mucahitc/Anten-Takip-PCB/README.md

# Anten Takip Sistemi — STM32H523 Kontrol Kartı

**Hareketli bir modülün konumunu kullanarak yönlü anteni iki eksende yönlendiren sistemin elektronik kontrol kartı.**

Bu depo; anten takip projesinin sabit modülüne ait **Altium Designer şematiklerini, dört katmanlı PCB tasarımını, bileşen kütüphanelerini, şematik PDF çıktısını ve STM32 yazılım başlangıç projesini** içerir.

<p align="center">
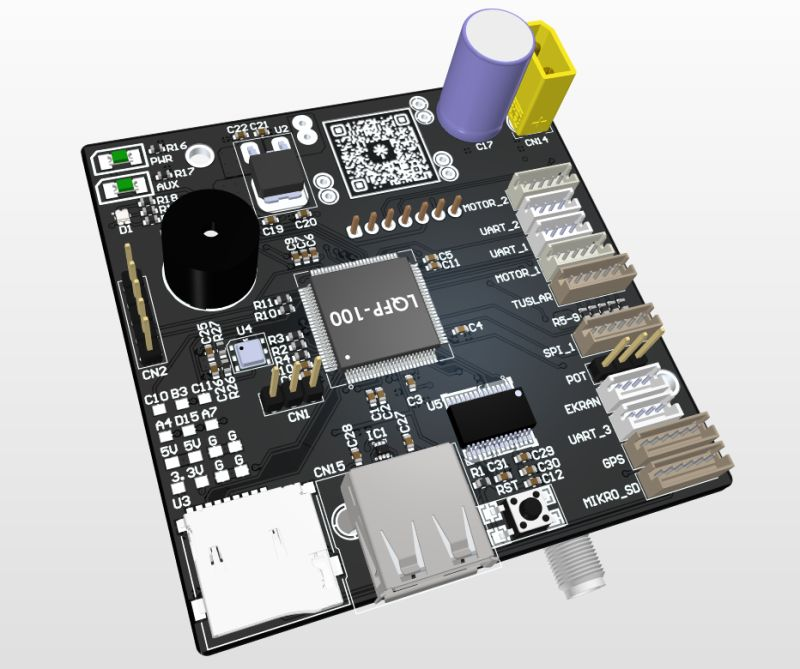
[picture p1: 1778805402399.jpg]
Anten takip kontrol kartının üç boyutlu tasarım görünümü
  
</p>

<p align="center"><em>STM32H523 tabanlı kontrol kartının üç boyutlu tasarım görünümü.</em></p>

[Şematik PDF](Job1.PDF) · [Altium projesi](Anten_Tracker_Karti.PrjPcb) · [PCB tasarımı](Anten-Tracker-PCB.PcbDoc) · [STM32 projesi](Anten_Tracker.zip)

## Proje hakkında

Anten takip sistemi, takip edilecek platforma yerleştirilen hareketli modül ile yerde bulunan sabit modül arasında konum verisi aktarılmasına dayanır. Sabit modül, kendi konumu ile hareketli modülün konumunu birlikte değerlendirerek antenin bakması gereken azimut ve elevasyon açılarını hesaplayan sistemin kontrol merkezidir.

Hareketli modül; İHA, İDA veya başka bir hareketli platforma yerleştirilebilecek şekilde düşünülmüştür. Takip edilen unsur bu modüldür; farklı araçlara uyarlama, ilgili platformun montaj ve kullanım koşullarına göre yapılır.

Bu depodaki PCB, projenin **sabit modül kontrol kartıdır**. Mekanik tasarım ve yer kontrol arayüzü sistemin diğer parçalarıdır; bu depo ağırlıklı olarak elektronik tasarıma odaklanır.

## Sistem nasıl çalışıyor?

mermaid-diagram

1. Hareketli modül, konum ve yükseklik verilerini toplar ve LoRa üzerinden gönderir.
2. Sabit modül, gelen verileri yerel konum ve yükseklik bilgileriyle birlikte değerlendirir.
3. Hesaplanan yön bilgisine göre yatay ve düşey eksenler kontrol edilir.
4. Yatay eksenin konumu potansiyometre üzerinden geri beslenir; telemetri ve sistem bilgileri yer kontrol istasyonuna aktarılır.

Bu akış, bütün sistemin çalışma prensibini gösterir.

## Donanım özellikleri

| Birim | Bileşen / yapı | Görevi |
| --- | --- | --- |
| Mikrodenetleyici | **STM32H523VET6**, LQFP100 | Çevre birimlerini ve kontrol bağlantılarını yönetme |
| PCB | **4 bakır katman** | Sinyal yönlendirmesi, güç dağıtımı ve toprak yapısı |
| Kablosuz haberleşme | **LoRa E22**, CARD1 | Hareketli modülle telemetri bağlantısı |
| USB–UART | **FT232**, U5 | Yer kontrol istasyonuyla seri haberleşme |
| USB hat elemanı | **NUF2042XV6T1G**, IC1 | USB hatlarında filtreleme ve ESD koruma işlevi |
| 5 V besleme | **MP1584EN modülü**, CARD2 | Şematikteki 12 V giriş hattından 5 V üretme |
| 3,3 V besleme | **LD1086DT33TR**, U2 | 5 V hattından 3,3 V üretme |
| Basınç sensörü | Şematikte **BMP180** olarak tanımlanan U4 | Barometrik ölçüm için I²C bağlantısı |
| GNSS SE100 bağlantısı | UART + I²C, CN8 | Harici konumlandırma modülüne bağlantı |
| Konum geri beslemesi | Analog potansiyometre girişi, CN7 | Yatay eksenin konumunu okuma |
| Motor arayüzleri | Zamanlayıcı çıkışları, CN3 ve CN4 | Harici sürücülere kontrol sinyallerini taşıma |
| Depolama bağlantısı | microSD yuvası U3 ve harici bağlantı CN6 | SPI tabanlı depolama altyapısı |
| Yerel kullanıcı arayüzü | Ekran ve beş yönlü tuş bağlantıları | Durum gösterimi ve kullanıcı girişi |
| Göstergeler | 0.96" OLED, RGB LED, durum LED’leri ve buzzer | Görsel ve sesli bildirim altyapısı |
| Geliştirme erişimi | SWD, BOOT0 ve reset | Programlama ve hata ayıklama |

Motor soketleri kontrol bağlantılarını dışarı taşır; DC motorun güç sürücüsü harici birimdir. microSD ve ek arayüzlerin kart üzerinde bulunması, tüm işlevlerin paylaşılan yazılımda uygulanmış olduğu anlamına gelmez.

## PCB yerleşimi

<table>
  <tr>
    <th>Ön yüz</th>
    <th>Arka yüz</th>
  </tr>
  <tr>
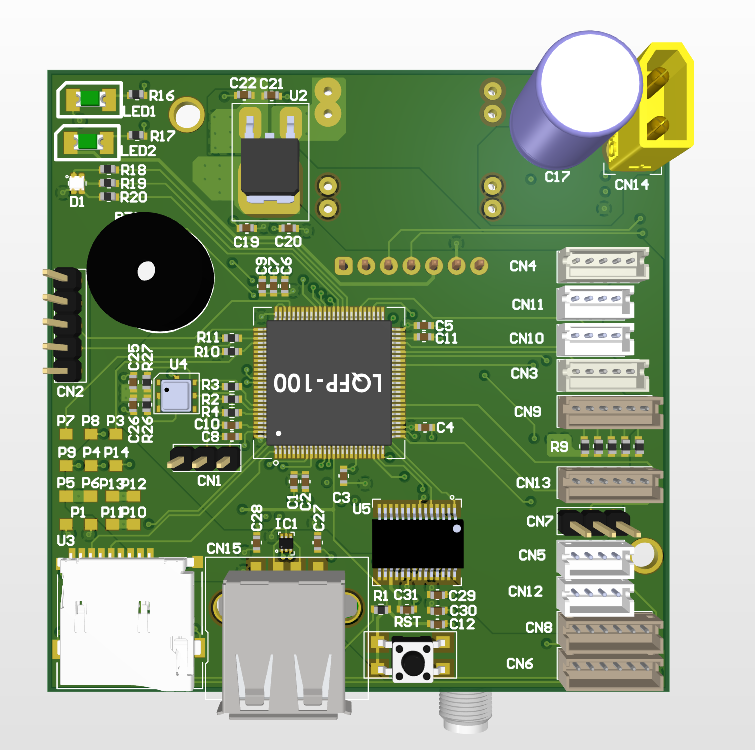
[picture p2: PCB-on-render.png]
Kontrol kartının ön yüz PCB renderı
    <td></td>
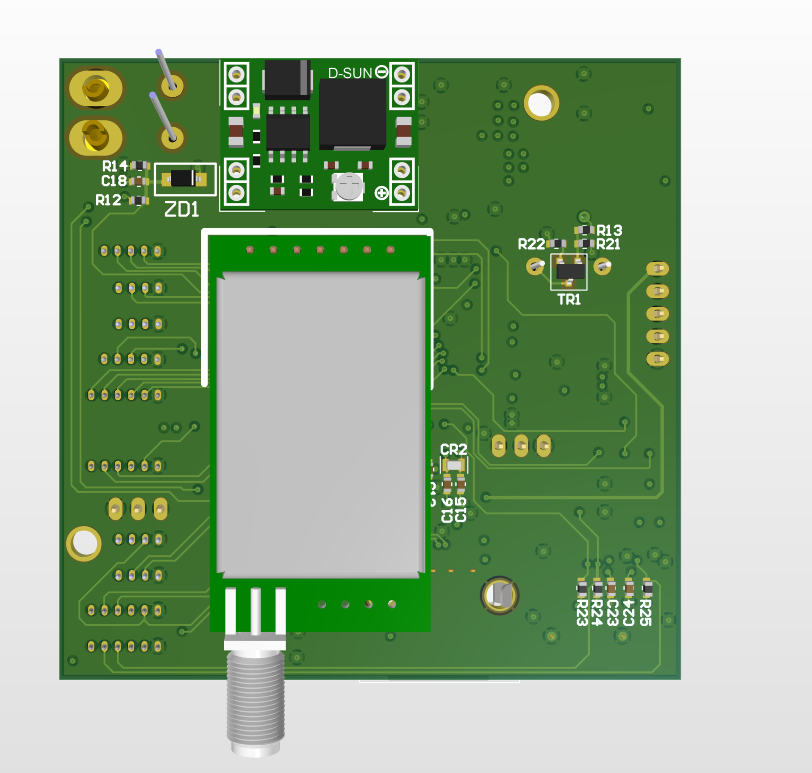
[picture p3: PCB-arka-render.png]
Kontrol kartının arka yüz PCB renderı
    <td></td>
  </tr>
</table>

Ön yüzde mikrodenetleyici, USB–UART devresi, sensör, microSD yuvası, göstergeler ve harici bağlantı soketleri bulunur. LoRa ve MP1584 modülleri arka yüze yerleştirilmiştir. Ön ve arka görseller, kartın ilgili yüzüne bakış yönünü gösterir.

### Katman yapısı

| Üstten alta | Tasarımdaki katman adı |
| --- | --- |
| 1 — Üst bakır | `SIG/GND` |
| 2 — İç bakır | `POWER` |
| 3 — İç bakır | `GND` |
| 4 — Alt bakır | `SIG/POW` |

Katman bilgisi PCB tasarım dosyasına aittir. Yukarıdaki renderlar dış yüzleri gösterir; iç katmanların bakır geometrisi Altium projesinden incelenebilir.

### Şematikten kart üzerindeki parçaya

| Devre bölümü | Referanslar | PCB üzerindeki yeri | Şematik dosyası |
| --- | --- | --- | --- |
| Güç girişi ve 5 V dönüşümü | CN14, C17, CARD2 | XT30 ve C17 ön yüzde; MP1584 modülü arka yüzde | [Dahili_Birimler.SchDoc](Dahili_Birimler.SchDoc) |
| 3,3 V regülasyonu | U2, C19–C22 | Ön yüzün üst bölümü | [Dahili_Birimler.SchDoc](Dahili_Birimler.SchDoc) |
| Mikrodenetleyici ve beslemesi | U1, C1–C11 | Ön yüzün merkezi ve U1 çevresi | [STM32.SchDoc](STM32.SchDoc) |
| USB–UART | CN15, IC1, U5 | Ön yüzün alt bölümü | [Dahili_Birimler.SchDoc](Dahili_Birimler.SchDoc) |
| LoRa | CARD1 | Arka yüzün geniş modül alanı | [Harici_Birimler.SchDoc](Harici_Birimler.SchDoc) |
| Barometre | U4 | Ön yüzde, mikrodenetleyicinin solu | [Dahili_Birimler.SchDoc](Dahili_Birimler.SchDoc) |
| Batarya ölçümü | R12, R14, C18, ZD1 | Arka yüzde güç modülünün yanı | [Dahili_Birimler.SchDoc](Dahili_Birimler.SchDoc) |
| Motor ve kullanıcı arayüzleri | CN3–CN5, CN7–CN9 | Ön yüzün sağ kenarı | [Harici_Birimler.SchDoc](Harici_Birimler.SchDoc) |
| microSD | U3, CN6 | Ön yüzde sol alt yuva ve sağ alt soket | [Dahili_Birimler.SchDoc](Dahili_Birimler.SchDoc), [Harici_Birimler.SchDoc](Harici_Birimler.SchDoc) |

## Üretilmiş kart

<table>
  <tr>
    <th>Ön yüz ve montaj</th>
    <th>Arka yüz ve modüller</th>
  </tr>
  <tr>
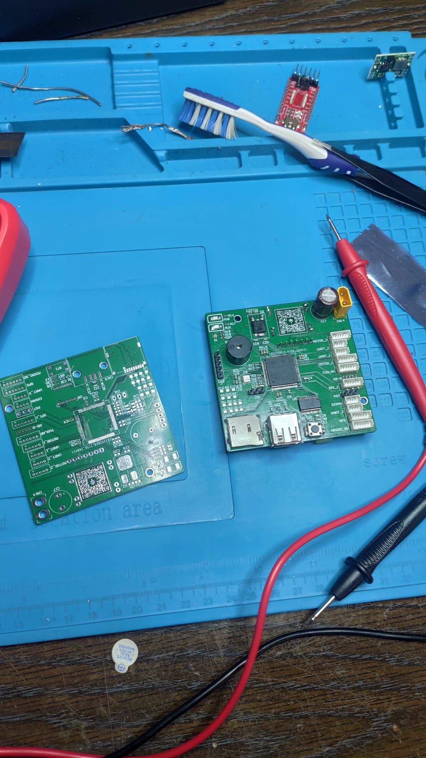
[picture p4: lehimli-lehimsiz-on.jpeg]
Üretilmiş kartın ön yüzü ve montaj aşaması
    <td></td>
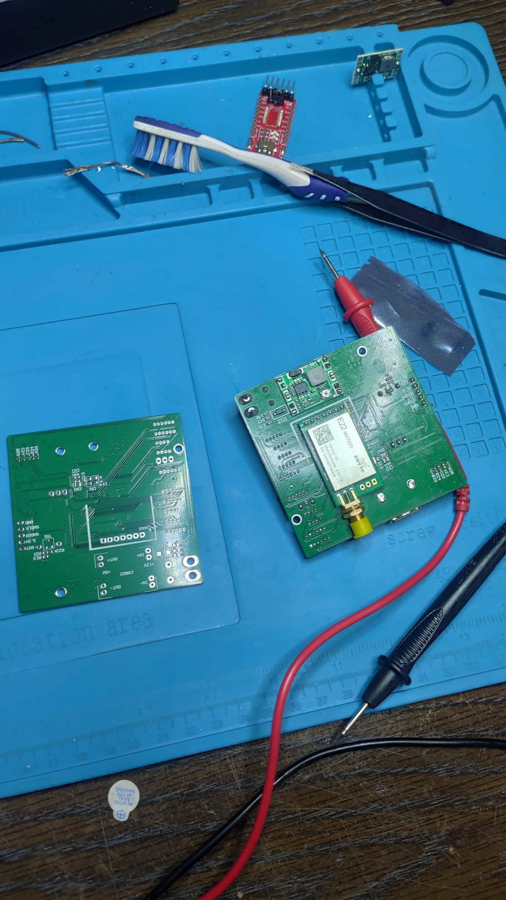
[picture p5: lehimli-lehimsiz-arka.jpeg]
Üretilmiş kartın arka yüzündeki LoRa ve güç modülleri
    <td></td>
  </tr>
</table>

Fotoğraflar, tasarımın üretilmiş ve bileşenleri monte edilmiş hâlini gösterir. Renderlar ile gerçek kartın renkleri ve görsel ayrıntıları farklı olabilir.

<p align="center">
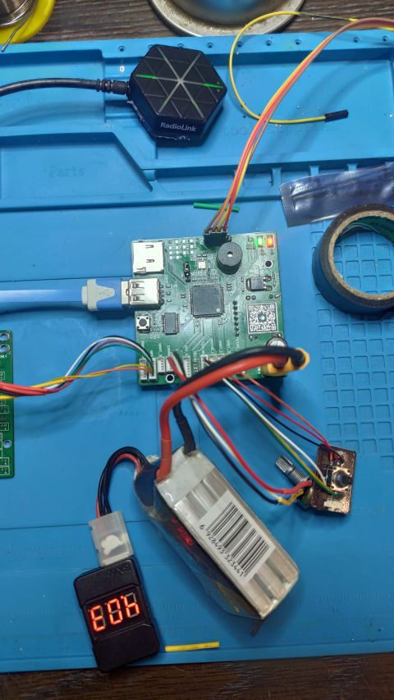
[picture p6: 1778805402253.jpg]
GNSS modülü, batarya ve harici bağlantılarla kontrol kartının masaüstü kurulumu
  
</p>

<p align="center"><em>GNSS modülü, batarya ve harici bağlantılarla masaüstü kurulumundan bir görünüm.</em></p>

## Dosya rehberi

| Dosya | İçerik |
| --- | --- |
| [Anten_Tracker_Karti.PrjPcb](Anten_Tracker_Karti.PrjPcb) | Altium Designer ana proje dosyası |
| [Anten-Tracker-PCB.PcbDoc](Anten-Tracker-PCB.PcbDoc) | PCB yerleşimi, yönlendirme ve katman yapısı |
| [STM32.SchDoc](STM32.SchDoc) | Mikrodenetleyici, besleme kapasitörleri, kristaller, reset, BOOT0 ve SWD |
| [Dahili_Birimler.SchDoc](Dahili_Birimler.SchDoc) | Güç devreleri, USB–UART, sensör, microSD, göstergeler ve batarya ölçümü |
| [Harici_Birimler.SchDoc](Harici_Birimler.SchDoc) | LoRa, motor, GNSS, ekran, tuş takımı ve genişleme bağlantıları |
| [Alici_Karti_Blok_Diyagram_V2.SchDoc](Alici_Karti_Blok_Diyagram_V2.SchDoc) | Alıcı/sabit modülün V2 blok diyagramı |
| [Alici_Karti_Blok_Diyagram.SchDoc](Alici_Karti_Blok_Diyagram.SchDoc) | Önceki alıcı mimarisi |
| [Verici_Karti_Blok_Diyagram.SchDoc](Verici_Karti_Blok_Diyagram.SchDoc) | Verici/hareketli modül blok diyagramı |
| [Anten-Tracker.SchLib](Anten-Tracker.SchLib) | Şematik sembol kütüphanesi |
| [Anten-Tracker.PcbLib](Anten-Tracker.PcbLib) | PCB footprint kütüphanesi |
| [Job1.PDF](Job1.PDF) | Blok diyagramlar ve ayrıntılı şematik sayfaları |
| [Job1.OutJob](Job1.OutJob) | Altium çıktı işi ayarları |
| [Anten_Tracker.zip](Anten_Tracker.zip) | STM32CubeIDE/CubeMX proje arşivi |

`Anten_Tracker_Karti.PrjPcbStructure` proje yapısına ait yardımcı dosyadır. PNG ve JPG/JPEG dosyaları tasarım renderlarını ve gerçek kart fotoğraflarını içerir.

**Sürüm notu:** Depoda farklı tasarım aşamalarına ait blok diyagramlar birlikte bulunur. Eski alıcı diyagramındaki STM32G071 ve diğer bileşen adları güncel kartla karıştırılmamalıdır. Ayrıntılı bağlantılar için `STM32.SchDoc`, `Dahili_Birimler.SchDoc`, `Harici_Birimler.SchDoc` ve PCB dosyası birlikte incelenmelidir.

## Tasarımı inceleme

### Altium Designer olmadan

[Job1.PDF](Job1.PDF) üzerinden şematikleri okuyabilirsiniz:

| PDF sayfası | İçerik |
| --- | --- |
| 1 | Verici kartı blok diyagramı |
| 2 | Önceki alıcı kartı blok diyagramı |
| 3 | Alıcı kartı blok diyagramı V2 |
| 4 | STM32 ve temel devreleri |
| 5 | Harici birim bağlantıları |
| 6 | Dahili birim devreleri |

Güncel kartın devrelerini incelemeye **4–6. sayfalardan** başlayabilirsiniz.

### Altium Designer ile

1. Depoyu indirin veya klonlayın:

   ```bash
   git clone https://github.com/mucahitc/Anten-Takip-PCB.git
   ```

2. `Anten_Tracker_Karti.PrjPcb` dosyasını Altium Designer’da açın.
3. Şematik sayfaları ve `Anten-Tracker-PCB.PcbDoc` dosyasını proje üzerinden inceleyin.
4. Kütüphane çözümlemesi gerekirse depodaki `.SchLib` ve `.PcbLib` dosyalarını kullanın.
5. Çıktı ayarlarını incelemek için `Job1.OutJob` dosyasını açın.

## Yazılım

[Anten_Tracker.zip](Anten_Tracker.zip) arşivi, `Anten_Tracker/` klasörü altında STM32CubeIDE proje dosyalarını, `Anten_Tracker.ioc` yapılandırmasını, `Core/` kaynaklarını ve `Drivers/` bileşenlerini içerir.

İncelemek için arşivi çıkarıp STM32CubeIDE’de **File → Import → General → Existing Projects into Workspace** yoluyla proje klasörünü seçebilirsiniz. `.ioc` dosyası pin ve çevre birimi yapılandırmalarını incelemek için kullanılabilir.

**Paylaşılan sürümün kapsamı:** Arşivdeki `Core/Src/main.c`, çevre birimi başlatmalarını içerir; ana `while (1)` uygulama döngüsü boştur. Bu arşiv, tamamlanmış anten takip algoritması ve yer kontrol yazılımı paketi olarak değerlendirilmemelidir. Yazılımı karta uyarlarken `.ioc` ayarları ile şematikteki pin bağlantıları birlikte kontrol edilmelidir.

## Ekip ve katkılar

| Katkı sağlayan | Sorumluluk |
| --- | --- |
| **[Mustafa Mücahit Çillioğlu](https://github.com/mucahitc)** | Elektronik tasarım, şematik ve PCB |
| **[Efe Kaan Yıldırım](https://www.linkedin.com/in/efe-kaan-y%C4%B1ld%C4%B1r%C4%B1m/)** | Mekanik tasarım |
| **[Kerem Kaya](https://www.linkedin.com/in/kerem-kaya-985837280/)** | Sistem yazılımı; paylaşılan STM32 yazılım dosyaları |

Bu kontrol kartı, elektronik, mekanik ve yazılım çalışmalarının bir araya geldiği anten takip projesinin elektronik bölümünü paylaşmak amacıyla hazırlanmıştır.
