mucahitc/Anten-Takip-PCB/Job1.PDF

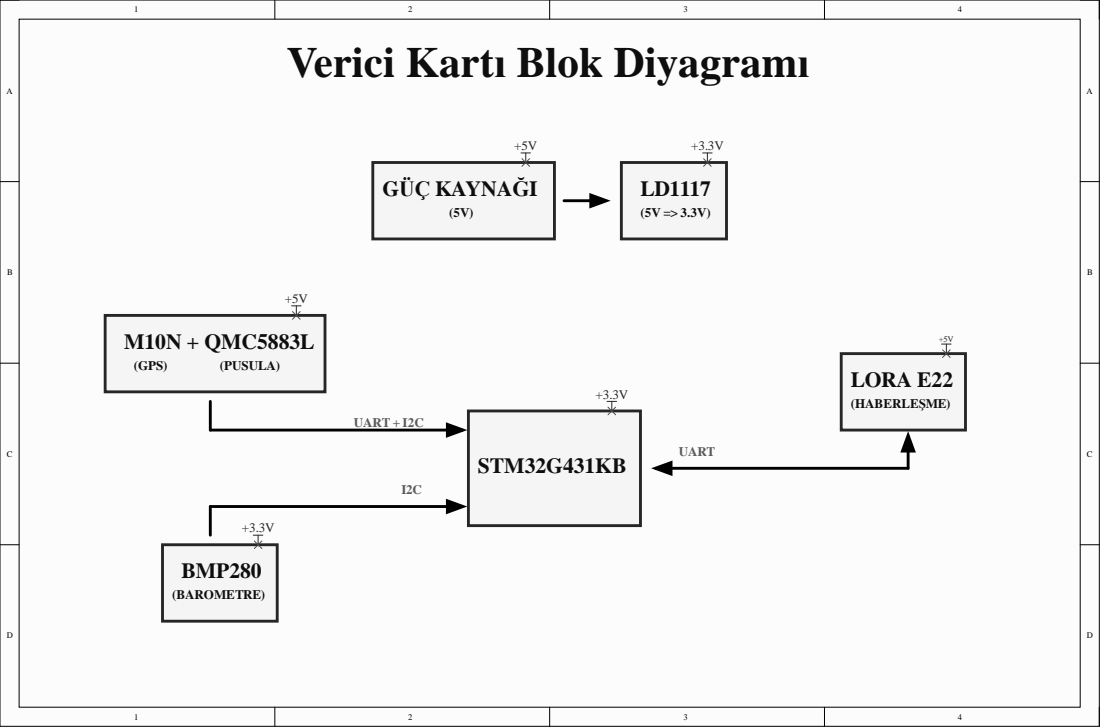
[picture p7: page 1]

Verici Kartı Blok Diyagramı

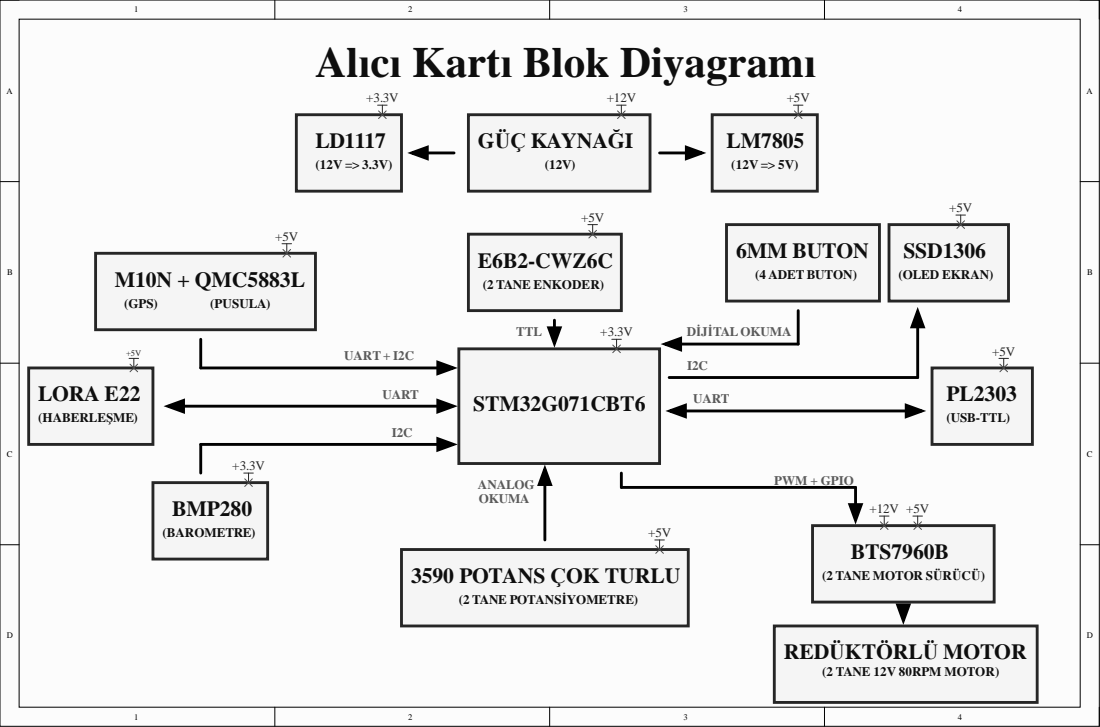
[picture p8: page 2]

Alıcı Kartı Blok Diyagramı

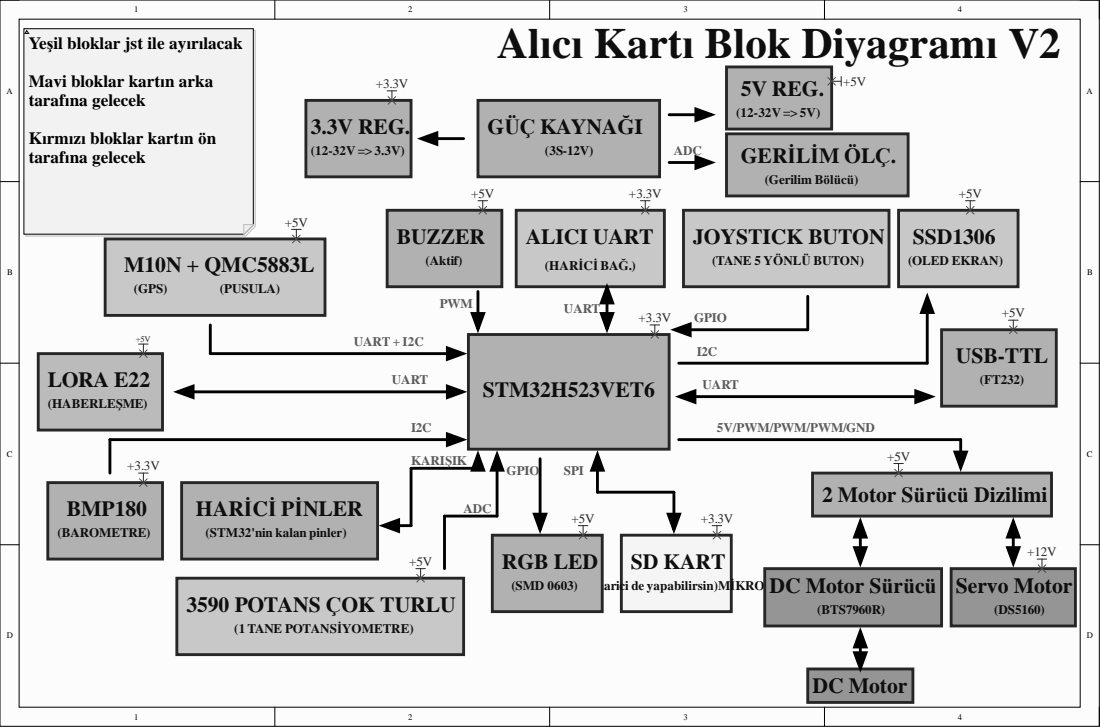
[picture p9: page 3]

Yeşil bloklar jst ile ayırılacak

Alıcı Kartı Blok Diyagramı V2

Mavi bloklar kartın arka
tarafına gelecek

Kırmızı bloklar kartın ön

GERİLİM ÖLÇ. (Gerilim Bölücü)

5V/PWM/PWM/PWM/GND

((harici de yapabilirsin)MİKRO SD)

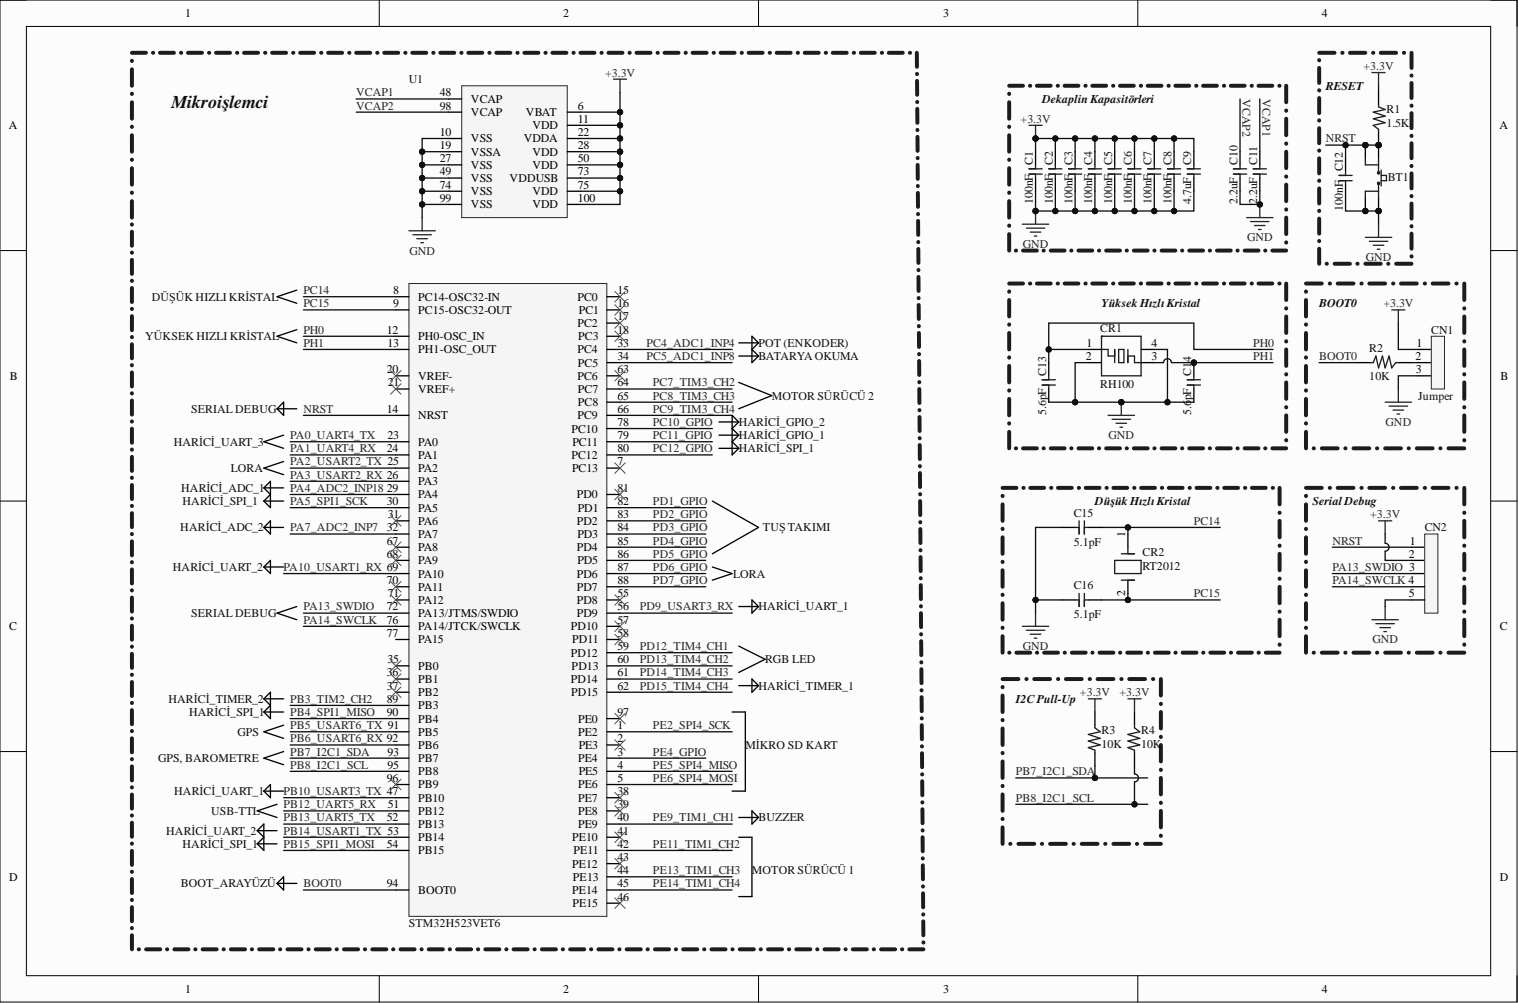
[picture p10: page 4]

1 9 | 2 8
2 7 | 5 0
4 9 | 7 3
7 4 | 7 5
9 9 | | 1 0 0

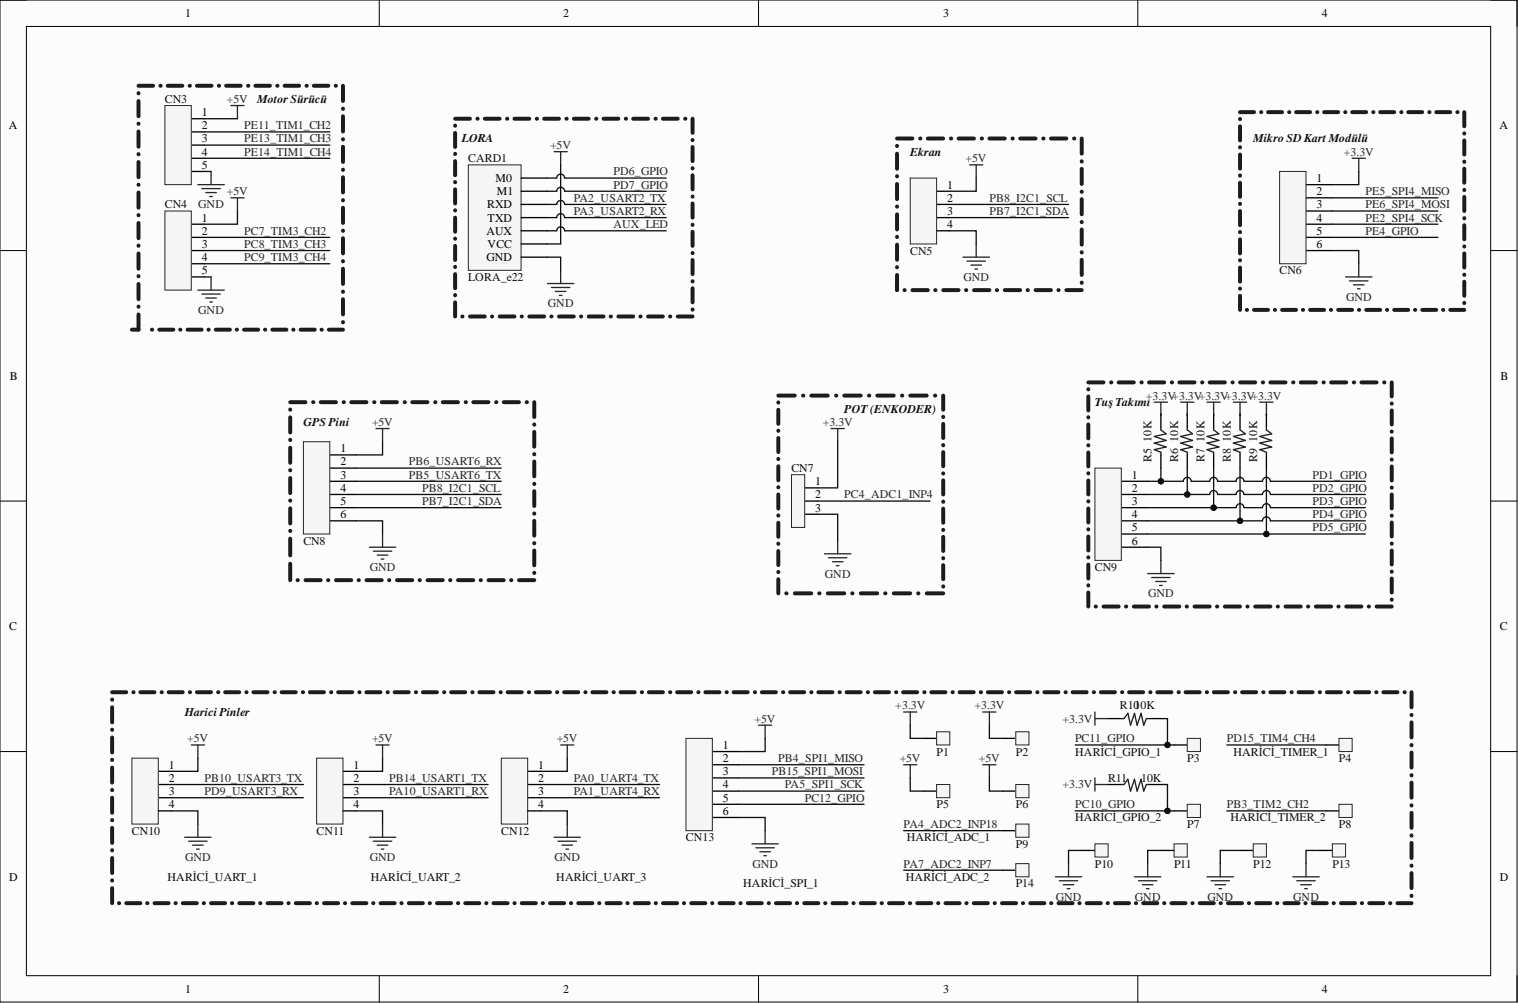
[picture p11: page 5]

Mikro SD Kart Modülü

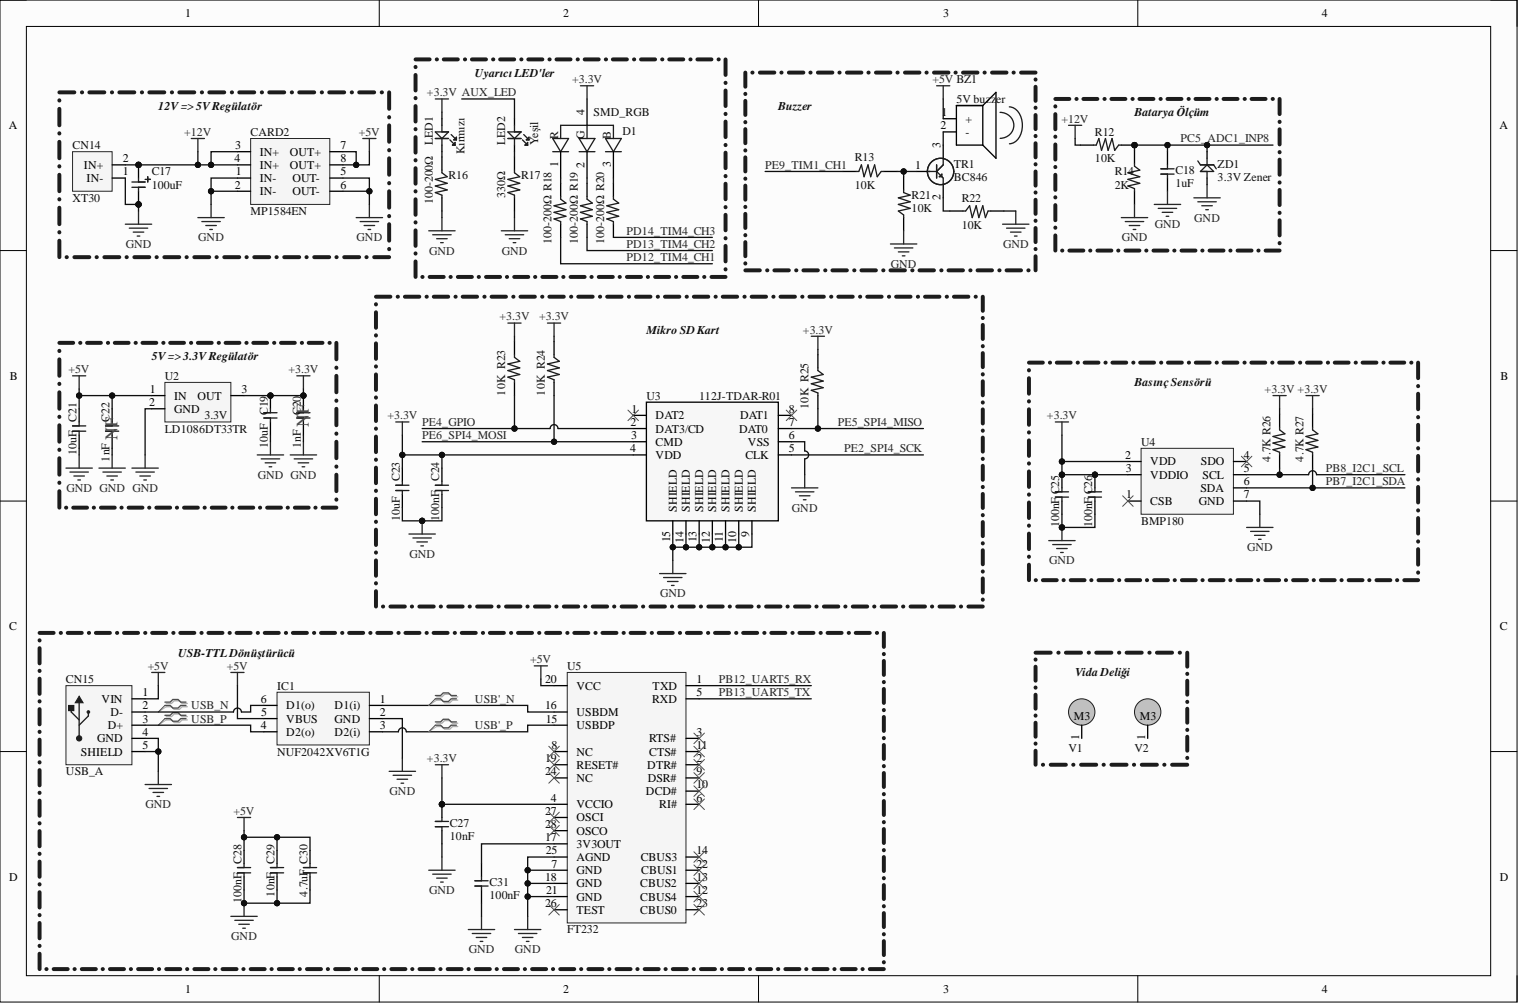
[picture p12: page 6]

SHIELD 9 SHIELD 10 SHIELD 11 SHIELD 12 SHIELD 13 SHIELD 14 SHIELD 15
