mucahitc/Anten-Takip-PCB/(list of files, drawings)

Other design files:
Alici_Karti_Blok_Diyagram.SchDoc
Alici_Karti_Blok_Diyagram_V2.SchDoc
Anten-Tracker-PCB.PcbDoc
Anten-Tracker.PcbLib
Anten-Tracker.SchLib
Anten_Tracker_Karti.PrjPcb
Dahili_Birimler.SchDoc
Harici_Birimler.SchDoc
STM32.SchDoc
Verici_Karti_Blok_Diyagram.SchDoc
